seeigecannon/DC27EnterpriseBadge/Board/enterprisePhaserTest.dxf

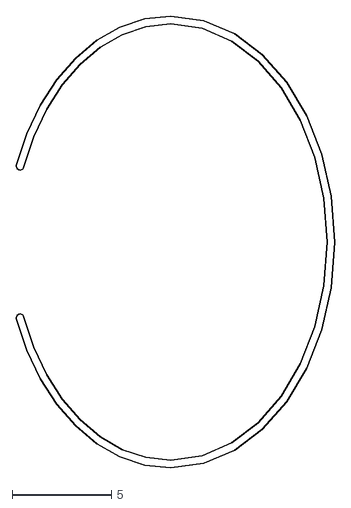
[picture p1: CAD file, 2019-08-08]
Board/enterprisePhaserTest.dxf
16.0 x 22.7
