seeigecannon/DC27EnterpriseBadge/Board/enterpriseNCCText.dxf

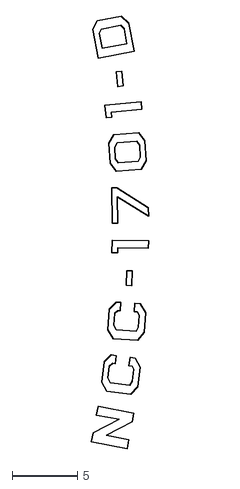
[picture p2: CAD file, 2019-08-08]
Board/enterpriseNCCText.dxf
4.38 x 33.1
