seeigecannon/DC27EnterpriseBadge/Board/enterpriseLineArt.dxf

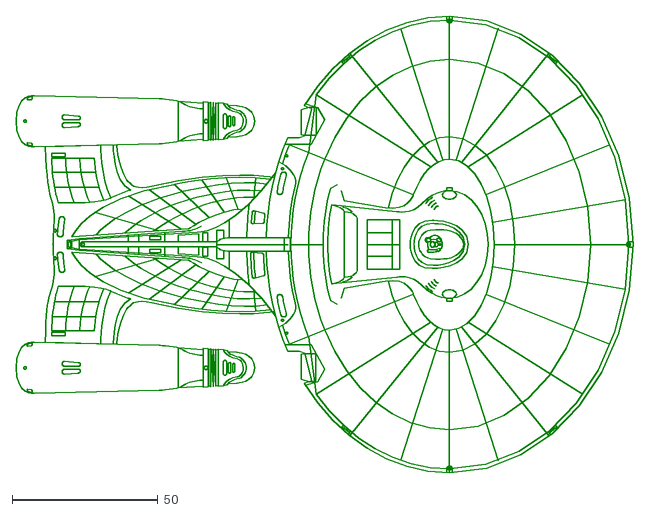
[picture p3: CAD file, 2019-08-08]
Board/enterpriseLineArt.dxf
211.4 x 156.4
