seeigecannon/DC27EnterpriseBadge/Board/enterprisePhaser.dxf

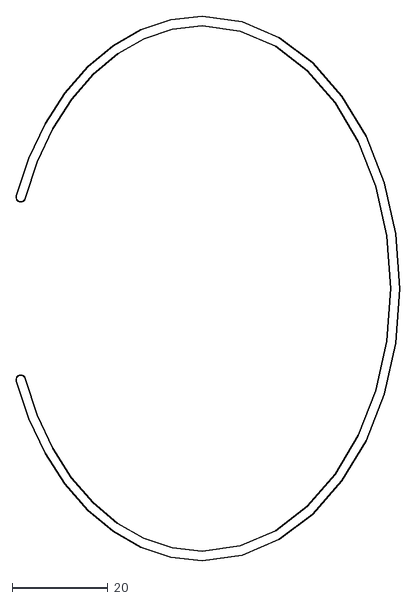
[picture p4: CAD file, 2019-08-08]
Board/enterprisePhaser.dxf
80.1 x 113.6
