seeigecannon/DC27EnterpriseBadge/Board/enterprisePhaserThin.dxf

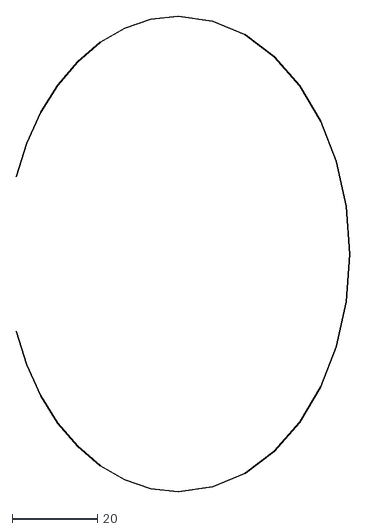
[picture p5: CAD file, 2019-08-08]
Board/enterprisePhaserThin.dxf
78.5 x 111.8
