seeigecannon/DC27EnterpriseBadge/Board/enterpriseOutline.dxf

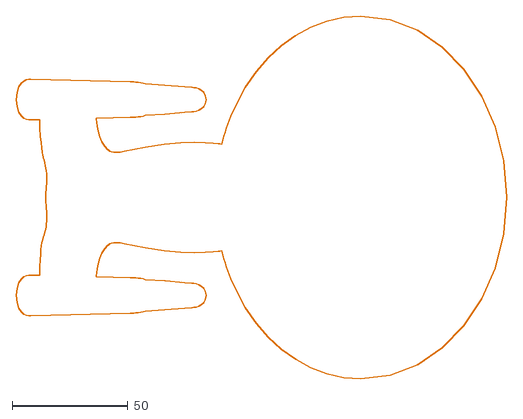
[picture p6: CAD file, 2019-08-08]
Board/enterpriseOutline.dxf
211.4 x 156.4
