seeigecannon/DC27EnterpriseBadge/Board/EnterpriseBadgeSchematic.pdf

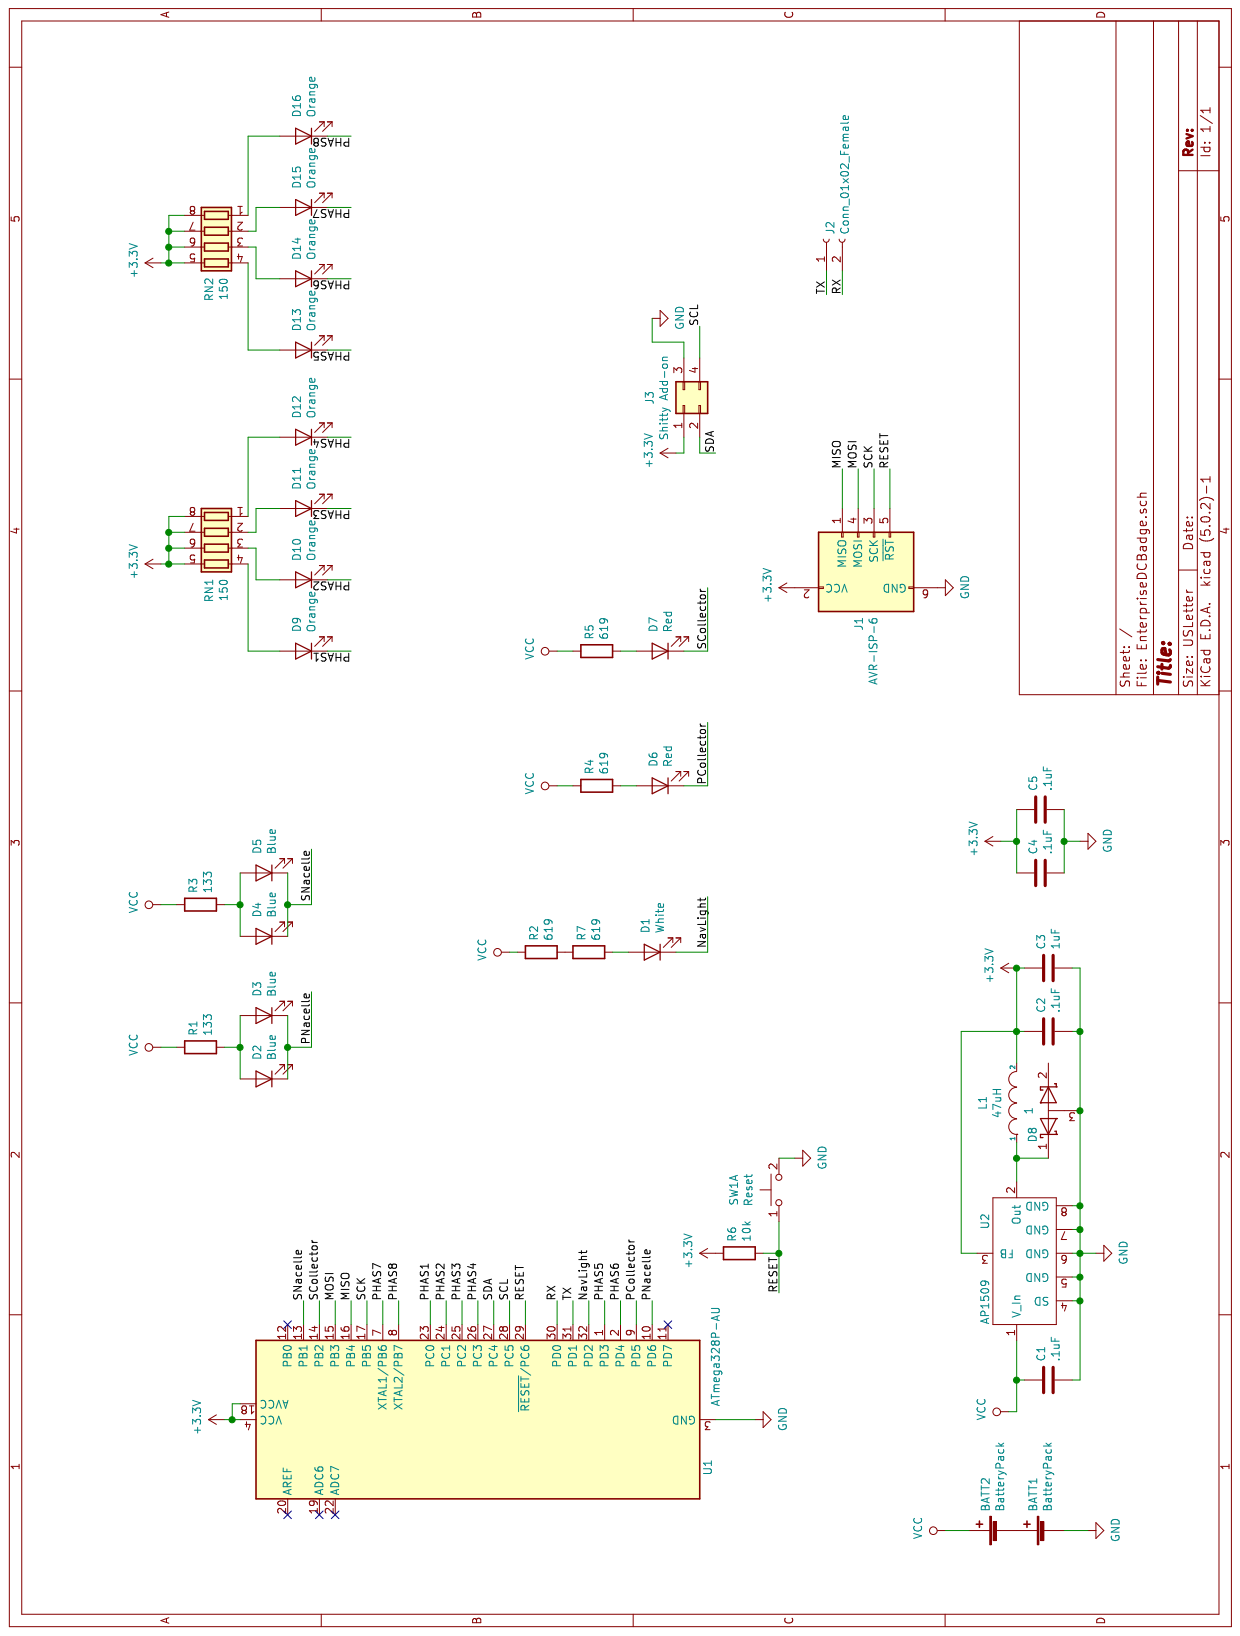
[picture p7: page 1]
