seeigecannon/DC27EnterpriseBadge/Board/EnterpriseDCBadge.kicad_pcb

## KiCad design Board/EnterpriseDCBadge.kicad_pcb (2019-08-08)

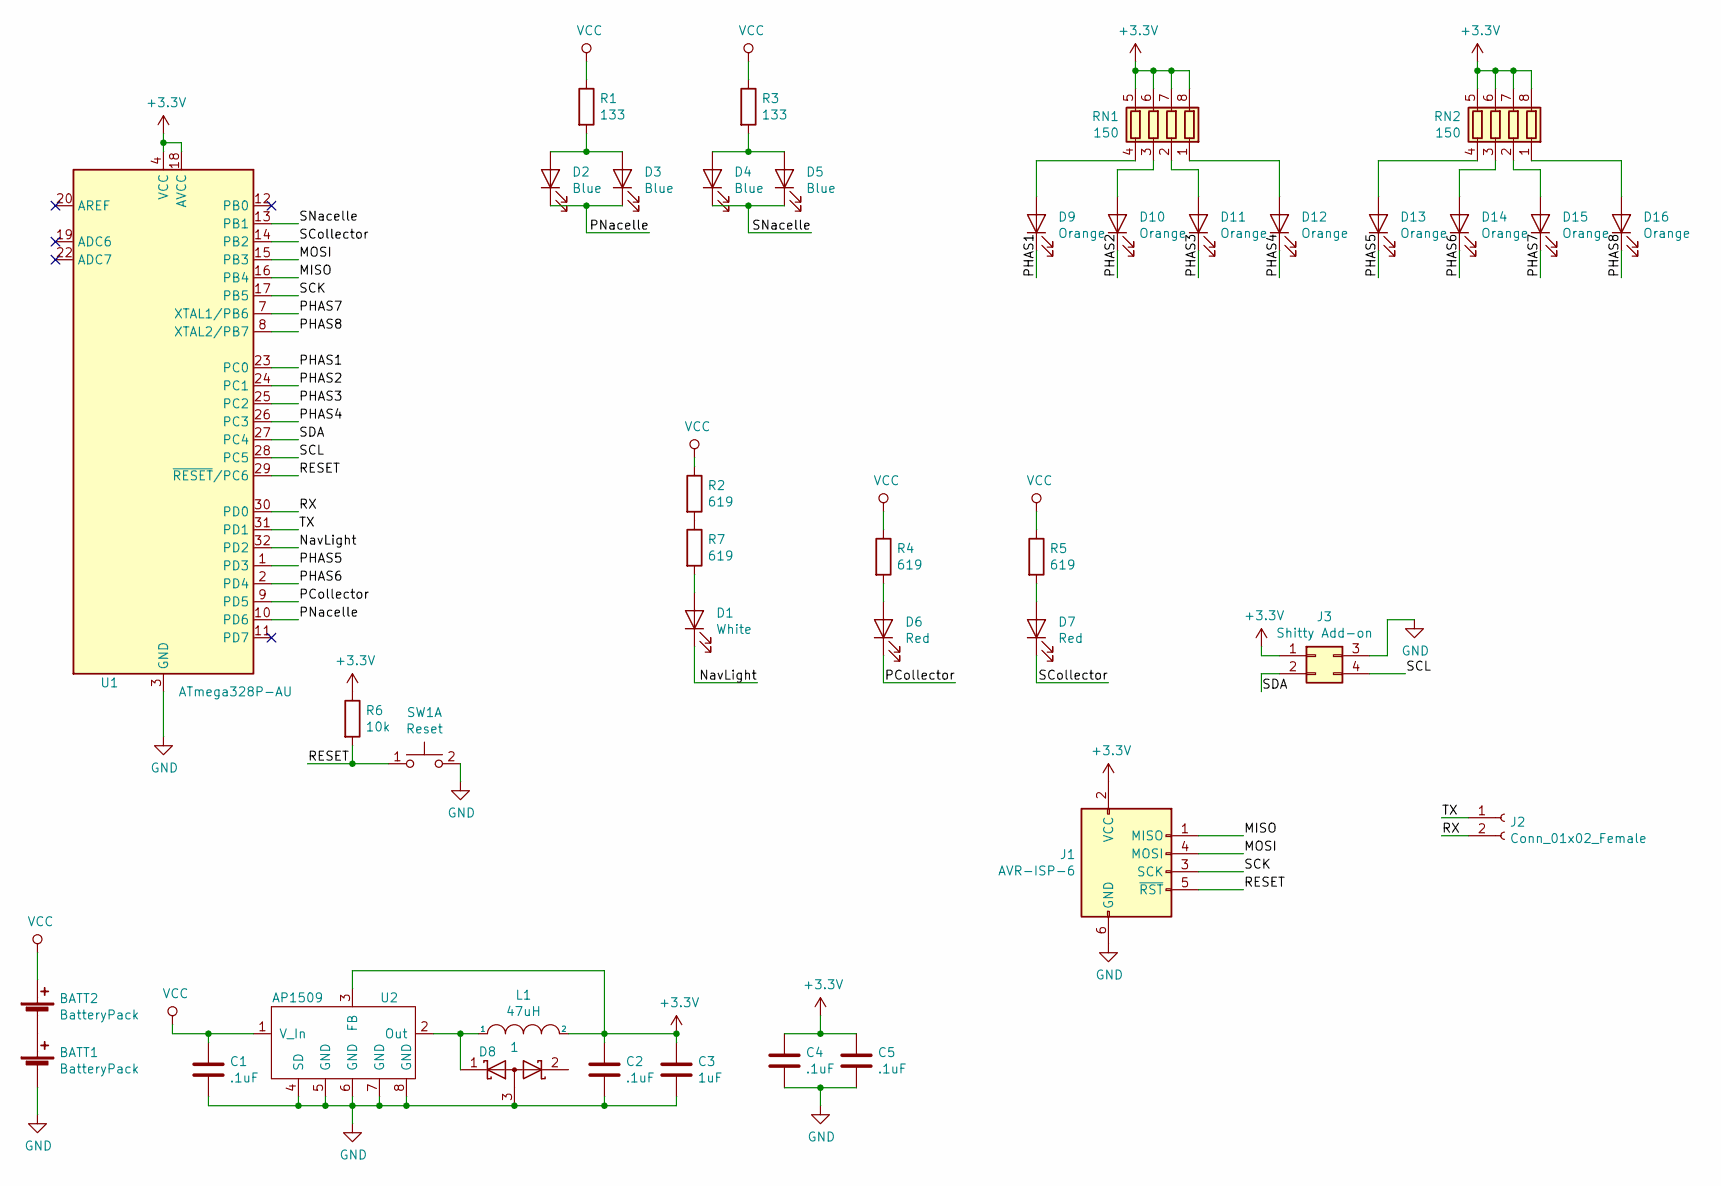
[picture p8: schematic EnterpriseDCBadge.sch]

Parts:
BATT1, BATT2: BatteryPack; BatteryHolder_MPD_BC12AAPC_2xAA_noHoles; Part Number BC12AAPC-ND
C1, C2, C4: .1uF; C_1206_3216Metric; Part Number 732-8086-1-ND
C3: 1uF; C_1206_3216Metric; Part Number 732-7685-1-ND
C5: .1uF; C_1206_3216Metric
D1: White; 3.8x1.2mm; Part Number 160-1869-1-ND
D2, D3, D4, D5: Blue; 2PLCC_flipped_noHole; Part Number 1497-1233-1-ND
D6, D7: Red; 2PLCC_flipped_noHole; Part Number 1497-1331-1-ND
D8: 1; SOT-23; Part Number BAS40-06LT1GOSCT-ND
D9, D10, D11, D12, D13, D14, D15, D16: Orange; 2PLCC_flipped_noHole; Part Number 475-2698-1-ND
J1: AVR-ISP-6; PinHeader_2x03_P2.54mm_Vertical; Part Number 609-3210-ND
J2: Conn_01x02_Female; PinHeader_1x02_P2.54mm_Vertical; Part Number 609-4434-ND
J3: Shitty Add-on; PinHeader_2x02_P2.54mm_Vertical; Part Number S7070-ND
L1: 47uH; L_1206_3216Metric_Pad1.42x1.75mm_HandSolder; Part Number 490-12803-1-ND
R1, R3: 133; R_1206_3216Metric; Part Number 311-133FRCT-ND
R2, R4, R5, R7: 619; R_1206_3216Metric; Part Number 311-619FRCT-ND
R6: 10k; R_1206_3216Metric; Part Number RMCF1206FT10K0CT-ND
RN1, RN2: 150; R_Array_Convex_4x1206; Part Number 744C083151JPCT-ND
SW1: Reset; SW_SPST_EVQQ2; Part Number CKN9088CT-ND
U1: ATmega328P-AU; TQFP-32_7x7mm_P0.8mm; Part Number ATMEGA328P-AURCT-ND
U2: AP1509; PowerIntegrations_SO-8; Part Number AP1509-33SGDICT-ND

Connections:
+3V3: C2.1, C3.1, C4.1, C5.1, J1.2 (VCC), J3.1, L1.2, R6.1, RN1.5 (R4.2), RN1.6 (R3.2), RN1.7 (R2.2), RN1.8 (R1.2), RN2.5 (R4.2), RN2.6 (R3.2), RN2.7 (R2.2), RN2.8 (R1.2), U1.4 (VCC), U1.6 (VCC), U1.18 (AVCC), U2.3 (FB)
/MISO: J1.1 (MISO), U1.16 (PB4)
/MOSI: J1.4 (MOSI), U1.15 (PB3)
/NavLight: D1.1 (K), U1.32 (PD2)
/PCollector: D6.1 (K), U1.9 (PD5)
/PHAS1: D9.1 (K), U1.23 (PC0)
/PHAS2: D10.1 (K), U1.24 (PC1)
/PHAS3: D11.1 (K), U1.25 (PC2)
/PHAS4: D12.1 (K), U1.26 (PC3)
/PHAS5: D13.1 (K), U1.1 (PD3)
/PHAS6: D14.1 (K), U1.2 (PD4)
/PHAS7: D15.1 (K), U1.7 (XTAL1/PB6)
/PHAS8: D16.1 (K), U1.8 (XTAL2/PB7)
/PNacelle: D2.1 (K), D3.1 (K), U1.10 (PD6)
/RESET: J1.5 (~RST), R6.2, SW1.1 (A), U1.29 (~RESET~/PC6)
/RX: J2.2, U1.30 (PD0)
/SCK: J1.3 (SCK), U1.17 (PB5)
/SCL: J3.4, U1.28 (PC5)
/SCollector: D7.1 (K), U1.14 (PB2)
/SDA: J3.2, U1.27 (PC4)
/SNacelle: D4.1 (K), D5.1 (K), U1.13 (PB1)
/TX: J2.1, U1.31 (PD1)
GND: BATT1.2 (-), C1.2, C2.2, C3.2, C4.2, C5.2, D8.3 (A), J1.6 (GND), J3.3, SW1.2 (B), U1.3 (GND), U1.5 (GND), U1.21 (GND), U2.4 (SD), U2.5 (GND), U2.6 (GND), U2.7 (GND), U2.8 (GND)
unnamed: BATT1.1 (+), BATT2.2 (-)
unnamed: D1.2 (A), R7.2
unnamed: D2.2 (A), D3.2 (A), R1.2
unnamed: D4.2 (A), D5.2 (A), R3.2
unnamed: D6.2 (A), R4.2
unnamed: D7.2 (A), R5.2
unnamed: D8.1 (K), L1.1, U2.2 (Out)
unnamed: D9.2 (A), RN1.4 (R4.1)
unnamed: D10.2 (A), RN1.3 (R3.1)
unnamed: D11.2 (A), RN1.2 (R2.1)
unnamed: D12.2 (A), RN1.1 (R1.1)
unnamed: D13.2 (A), RN2.4 (R4.1)
unnamed: D14.2 (A), RN2.3 (R3.1)
unnamed: D15.2 (A), RN2.2 (R2.1)
unnamed: D16.2 (A), RN2.1 (R1.1)
unnamed: R2.2, R7.1
VCC: BATT2.1 (+), C1.1, R1.1, R2.1, R3.1, R4.1, R5.1, U2.1 (V_In)

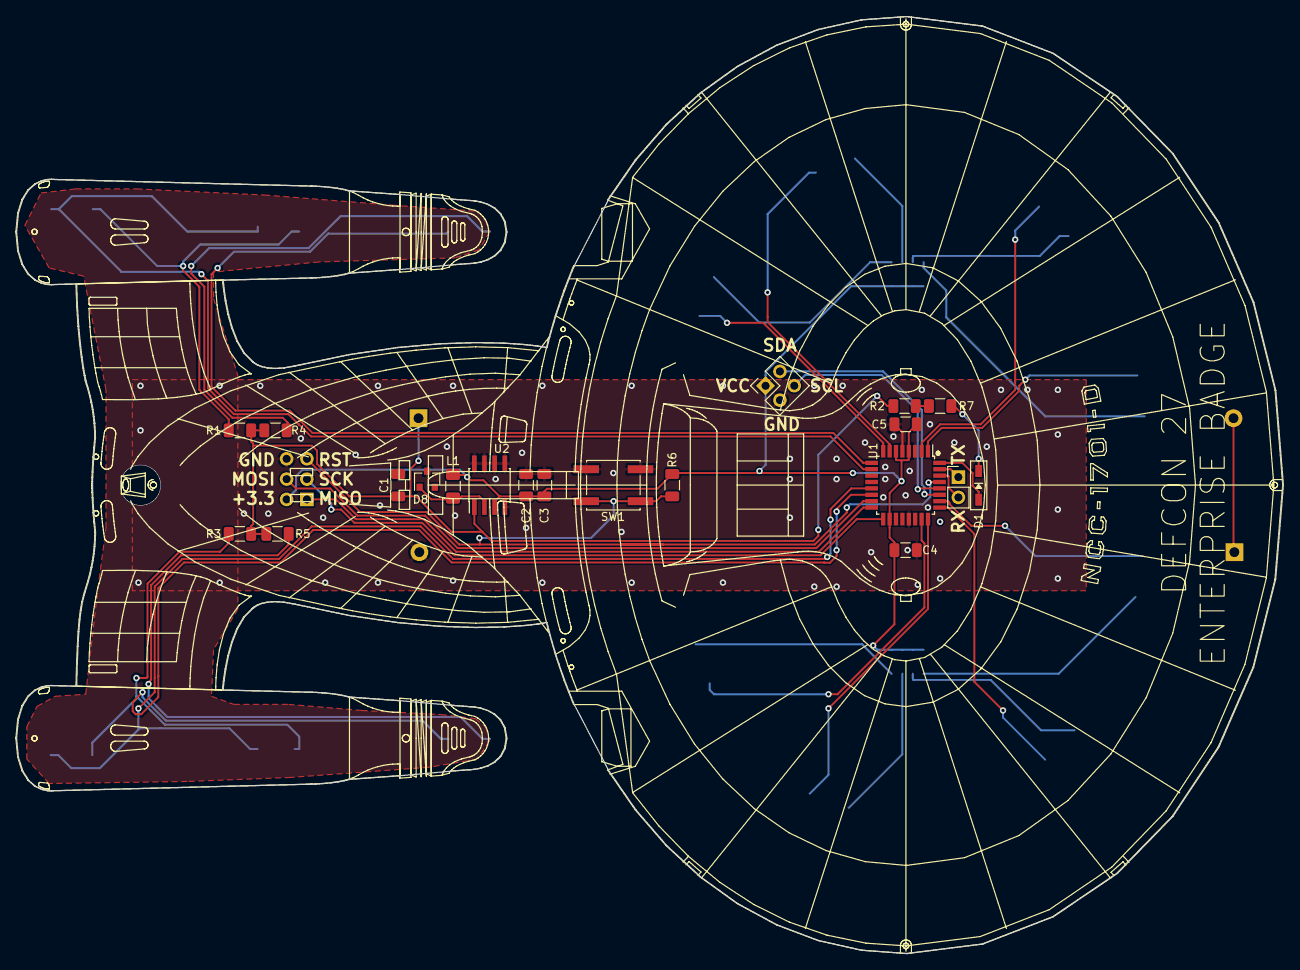
[picture p9: board EnterpriseDCBadge.kicad_pcb from above]

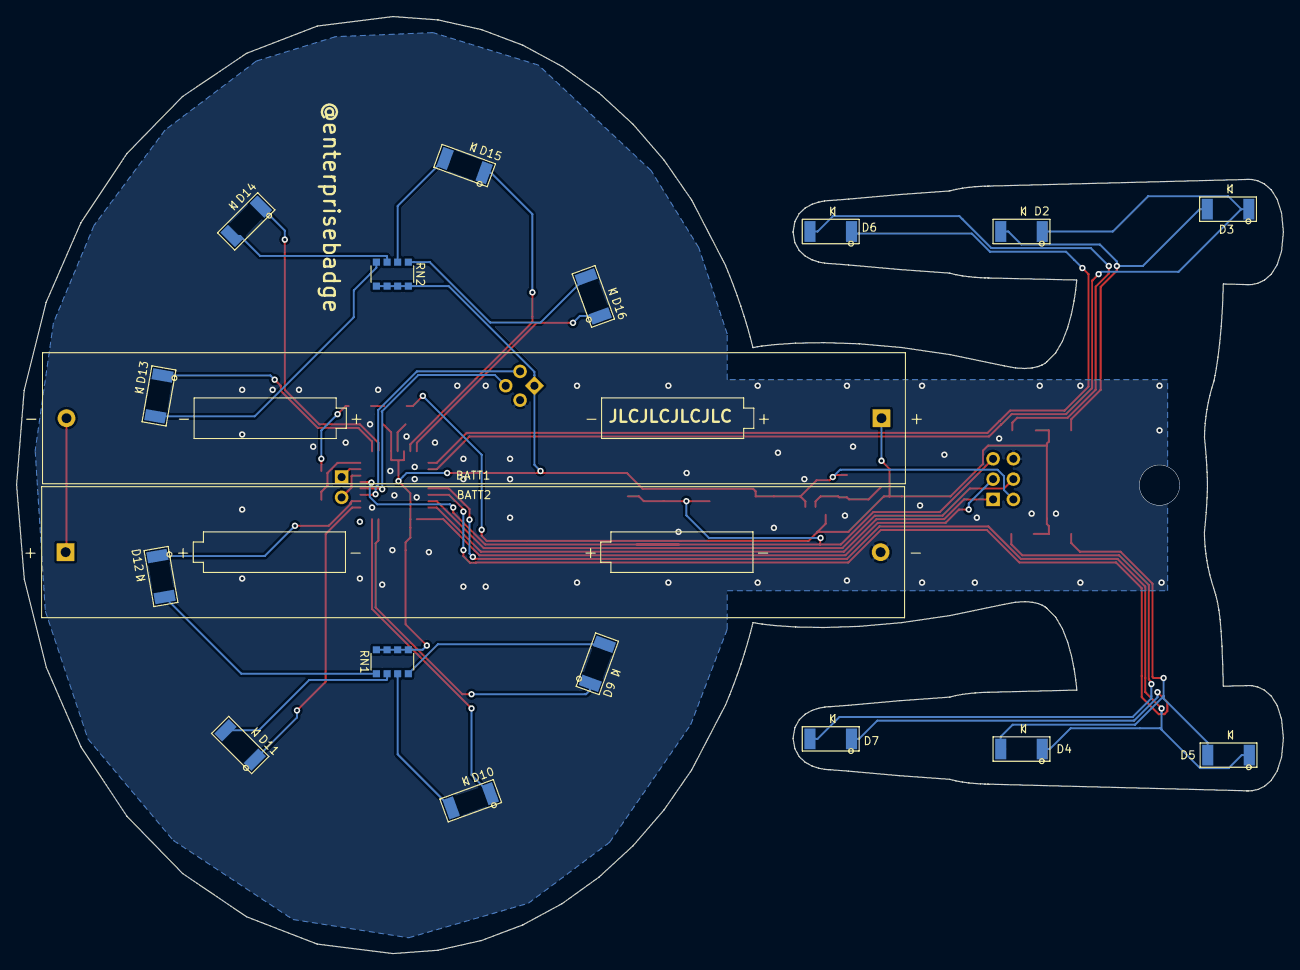
[picture p10: board EnterpriseDCBadge.kicad_pcb from below]

Board: 2 copper layers, 158.6 x 117.3 mm, 39 parts (18 on the bottom side), 40 nets.
