seeigecannon/DC27EnterpriseBadge/code/enterpriseCode/enterpriseCode.ino

#include <avr/power.h>
#include <avr/sleep.h>
#include <avr/wdt.h>
#include <EEPROM.h>

void setOtherLEDs();
void setPhasers(uint8_t phaserArray);
void POST();
void NavLightToggle(bool navLightOn);
void damageNacelles(int damage);
void firePhasers();

long unsigned int timer=0;
long unsigned int lastTimer=0;
unsigned int timerDelay=10;   //milliseconds per run
long unsigned int randomPhaserTimer=random(5000);
long unsigned int randomPhaserTimerBuffer=0;
unsigned int boardMode;     //modes: normal phaser, binary counter, larson scanner, disco

uint8_t otherLEDs=B0000000;    //0,0,0,PNacelle,PCollector/NavLight/SCollector,SNacelle
const uint8_t PNacelle     = 0b00010000;
const uint8_t PCollector   = 0b00001000;
const uint8_t NavLight     = 0b00000100;
const uint8_t SCollector   = 0b00000010;
const uint8_t SNacelle     = 0b00000001;
unsigned short phaserCounter=0;
byte larsonScanner=B00000001;
bool larsonScannerDirection=false;
/**
 * PFM profiles were generated with the following python code:
 *
 * import math
 *
 * sigmoid = lambda x: math.exp(x) / (1.0 + math.exp(x))
 *
 * pulse_profile1 = [ 10000.0*sigmoid(10.0 * (x / 100.0) - 5.0) for x in range(0, 100, 1) ]
 * pulse_profile2 = [ 7000.0*sigmoid(10.0 * (x / 100.0) - 5.0) for x in range(0, 100, 1) ]
 * pulse_profile3 = [ 5000.0*sigmoid(10.0 * (x / 100.0) - 5.0) for x in range(0, 100, 1) ]
 * pulse_profile4 = [ 3500.0*sigmoid(10.0 * (x / 100.0) - 5.0) for x in range(0, 100, 1) ]
 *
 * A few notes about the above:
 *
 * 1.  PFM profiles represent a sequence of pulse periods in microseconds.  LEDs are dimmed
 *     using PFM at 50% DC and the given pulse periods.
 * 2.  sum(pulse_profile1) ~= 500e3, i.e. 500ms
 *     sum(pulse_profile2) ~= 70%*sum(pulse_profile1)
 *     sum(pulse_profile3) ~= 70%*sum(pulse_profile2)
 *     sum(pulse_profile4) ~= 70%*sum(pulse_profile3)
 *
 */
const uint16_t pulse_profile1[] = {
	66.928509242848563,
    73.915413442819712,
    81.625711531598967,
    90.132986528478227,
    99.518018669043258,
    109.8694263059318,
    121.28434984274234,
    133.86917827664777,
    147.74031693273057,
    163.02499371440948,
    179.86209962091556,
    198.40305734077509,
    218.81270936130477,
    241.270214176692,
    265.96993576865862,
    293.12230751356316,
    322.95464698450508,
    355.71189272636178,
    391.65722796764356,
    431.07254941086114,
    474.25873177566785,
    521.53563078417733,
    573.24175898868759,
    629.73356056996511,
    691.3842034334682,
    758.58180021243561,
    831.72696493922376,
    911.22961014856151,
    997.50489119685176,
    1090.9682119561294,
    1192.0292202211754,
    1301.0847436299785,
    1418.5106490048781,
    1544.6526508353472,
    1679.8161486607555,
    1824.2552380635632,
    1978.1611144141821,
    2141.6501695744146,
    2314.7521650098233,
    2497.3989440488244,
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
};
const uint16_t pulse_profile2[] = {
	46.849956469993991,
    51.740789409973793,
    57.137998072119274,
    63.093090569934752,
    69.662613068330288,
    76.908598414152252,
    84.899044889919637,
    93.70842479365345,
    103.41822185291139,
    114.11749560008664,
    125.90346973464089,
    138.88214013854258,
    153.16889655291334,
    168.88914992368439,
    186.17895503806102,
    205.1856152594942,
    226.06825288915357,
    248.99832490845327,
    274.16005957735047,
    301.75078458760282,
    331.98111224296753,
    365.07494154892419,
    401.26923129208132,
    440.8134923989756,
    483.96894240342772,
    531.007260148705,
    582.20887545745666,
    637.860727103993,
    698.25342383779628,
    763.67774836929061,
    834.42045415482278,
    910.759320540985,
    992.95745430341481,
    1081.2568555847431,
    1175.8713040625289,
    1276.9786666444943,
    1384.7127800899273,
    1499.15511870209,
    1620.3265155068762,
    1748.1792608341771,
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
};
const uint16_t pulse_profile3[] = {
	33.464254621424281,
    36.957706721409856,
    40.812855765799483,
    45.066493264239114,
    49.759009334521629,
    54.9347131529659,
    60.642174921371172,
    66.934589138323886,
    73.870158466365282,
    81.512496857204738,
    89.931049810457779,
    99.201528670387546,
    109.40635468065239,
    120.635107088346,
    132.98496788432931,
    146.56115375678158,
    161.47732349225254,
    177.85594636318089,
    195.82861398382178,
    215.53627470543057,
    237.12936588783393,
    260.76781539208866,
    286.6208794943438,
    314.86678028498255,
    345.6921017167341,
    379.2909001062178,
    415.86348246961188,
    455.61480507428075,
    498.75244559842588,
    545.48410597806469,
    596.01461011058768,
    650.54237181498922,
    709.25532450243907,
    772.32632541767362,
    839.90807433037776,
    912.12761903178159,
    989.080557207091,
    1070.8250847872073,
    1157.3760825049117,
    1248.6994720244122,
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
};
const uint16_t pulse_profile4[] = {
	23.424978234996995,
    25.870394704986897,
    28.568999036059637,
    31.546545284967376,
    34.831306534165144,
    38.454299207076126,
    42.449522444959818,
    46.854212396826725,
    51.709110926455693,
    57.058747800043321,
    62.951734867320447,
    69.441070069271291,
    76.584448276456669,
    84.444574961842193,
    93.08947751903051,
    102.5928076297471,
    113.03412644457679,
    124.49916245422664,
    137.08002978867523,
    150.87539229380141,
    165.99055612148376,
    182.53747077446209,
    200.63461564604066,
    220.4067461994878,
    241.98447120171386,
    265.50363007435249,
    291.10443772872833,
    318.93036355199649,
    349.12671191889814,
    381.83887418464531,
    417.21022707741139,
    455.37966027049248,
    496.4787271517074,
    540.62842779237155,
    587.93565203126445,
    638.48933332224715,
    692.35639004496363,
    749.577559351045,
    810.16325775343807,
    874.08963041708853,
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
};
void readSetEEPROM(){
    if(EEPROM.read(0)>3){   //if EEPROM is too high, reset back to 0
        EEPROM.write(0,0);
    }
    boardMode=EEPROM.read(0);
    EEPROM.write(0,boardMode+1);
    //setPhasers(EEPROM.read(0)+1); //debug
}
// the setup function runs once when you press reset or power the board
void setup() {
    wdt_enable(WDTO_8S);
    delay(50);  //debounce reset button
    readSetEEPROM();    //change mode with reset button
    ADCSRA = 0; //disable ADC to save power
    POST();
    
}

// otherLEDs:
//   bit 4: PNacelle
//   bit 3: PCollector
//   bit 2: NavLight
//   bit 1: SCollector
//   bit 0: SNacelle
void setOtherLEDs() {
    // PNacelle = PD6
    // PCollector = PD5
    // NavLight = PD2
    // SCollector = PB2
    // SNacelle = PB1
	static const uint8_t DDRDMask = 0b01100100;
	static const uint8_t DDRBMask = 0b00000110;
    bool pNacelle = otherLEDs & PNacelle;
    bool pCollector = otherLEDs & PCollector;
    bool navLight = otherLEDs & NavLight;
    bool sCollector = otherLEDs & SCollector;
    bool sNacelle = otherLEDs & SNacelle;
    DDRD = DDRD & ~DDRDMask | (pNacelle << 6) | (pCollector << 5) | (navLight << 2);
    DDRB = DDRB & ~DDRBMask | (sCollector << 2) | (sNacelle << 1);
}

void setPhasers(uint8_t phaserMask) {
    //PHAS1=PC0
    //PHAS2=PC1
    //PHAS3=PC2
    //PHAS4=PC3
    //PHAS5=PD3
    //PHAS6=PD4
    //PHAS7=PB6
    //PHAS8=PB7
	static const uint8_t DDRBMask = 0b11000000;
	static const uint8_t DDRCMask = 0b00001111;
	static const uint8_t DDRDMask = 0b00110000;
    uint8_t DDRBbits = phaserMask & DDRBMask;
    uint8_t DDRCbits = phaserMask & DDRCMask;
    uint8_t DDRDbits = phaserMask & DDRDMask;
    DDRB = DDRB & ~DDRBMask | DDRBbits;
    DDRC = DDRC & ~DDRCMask | DDRCbits;
    DDRD = DDRD & ~(DDRDMask >> 1) | (DDRDbits >> 1);
}
void POST(){
    uint8_t phaserTest=B0000001;
    otherLEDs=B00000001;
    for(int i=0; i<9; i++){
        setPhasers(phaserTest);
        delay(200);
        phaserTest=phaserTest<<1;
    }
    for(int i=0; i<6; i++){
        setOtherLEDs();
        delay(200);
        otherLEDs=otherLEDs<<1;
    }
}
void NavLightToggle(bool navLightOn=false){
    //otherLEDs=otherLEDs^B00000100;
    if(navLightOn){
        otherLEDs |= NavLight;
    }
    else{
        otherLEDs &= ~NavLight;
    }
    setOtherLEDs();
}
void damageNacelles(int damage=0){
    if(damage==0){
        otherLEDs &= NavLight;
    }
    else if(damage==1){
        otherLEDs &= NavLight|SCollector|SNacelle;
    }
    else if (damage==2){
        otherLEDs &= NavLight|PCollector|PNacelle;
    }
    else{
        otherLEDs |= PCollector|PNacelle|SCollector|SNacelle;
    }
    setOtherLEDs();
}

void loop() {
    wdt_reset();
    if(boardMode==0){   //normalMode
        if(millis()-lastTimer>timerDelay){
            lastTimer=millis();
        }
        if(millis()-randomPhaserTimerBuffer>randomPhaserTimer){
            randomPhaserTimerBuffer=millis();
            randomPhaserTimer=random(10000);
            damageNacelles(random(0,20));
            
            firePhasers();
        }
        //otherLEDs = PCollector|PNacelle|SCollector|SNacelle;
        NavLightToggle(1);
    }
    else if(boardMode==1){  //binCounter mode

        setPhasers(phaserCounter);
        otherLEDs=phaserCounter>>8;
        setOtherLEDs();
        delay(100);
        phaserCounter=phaserCounter+1;
    }
    else if(boardMode==2){  //larsonScanner
        otherLEDs=B11111111;
        setOtherLEDs();
        setPhasers(larsonScanner);
        if(larsonScannerDirection==false){
            larsonScanner=larsonScanner<<1;
        }
        else{
            larsonScanner=larsonScanner>>1;
        }
        if(larsonScanner==B10000000 or larsonScanner==B00000001){
            larsonScannerDirection=!larsonScannerDirection;
        }
        delay(200);
    }
    else{       //discoMode
        setPhasers(random(255));
        otherLEDs=random();
        setOtherLEDs();
        delay(random(300,1000));
    }
}

void crossFade(uint8_t start, uint8_t end, const uint16_t pulse_periods_us[], int n_steps) {
	// PFM @start from 100% down to 0% and @end from 0% up to 100%
	for (int i = 0; i < n_steps; i++) {
		setPhasers(start);
		delayMicroseconds(pulse_periods_us[n_steps-i] / 2);
		setPhasers(end);
		delayMicroseconds(pulse_periods_us[i] / 2);
	}
	setPhasers(end);
}

void firePhasers(){
	crossFade(0b00000000, 0b10000001, pulse_profile1, sizeof(pulse_profile1)/sizeof(pulse_profile1[0]));
	crossFade(0b10000001, 0b01000010, pulse_profile2, sizeof(pulse_profile2)/sizeof(pulse_profile2[0]));
	crossFade(0b01000010, 0b00100100, pulse_profile3, sizeof(pulse_profile3)/sizeof(pulse_profile3[0]));
	crossFade(0b00100100, 0b00011000, pulse_profile4, sizeof(pulse_profile4)/sizeof(pulse_profile4[0]));
    if(random(2)==0){
        setPhasers(B00001000);
    }
    else{
        setPhasers(B00010000);
    }
    delay(600);
    setPhasers(0b00000000);
}
