seeigecannon/DC27EnterpriseBadge/(commit log)

2019-08-08 Add files via upload
    Sorry about the mess...
    [DEV_EnterpriseDCBadge.kicad_pcb, EnterpriseDCBadge - Copy.kicad_pcb, EnterpriseDCBadge.csv, EnterpriseDCBadge.kicad_pcb, EnterpriseDCBadge.sch, enterpriseLineArt.dxf, enterpriseNCCText.dxf, enterpriseOutline.dxf]
2021-08-10 Add files via upload
    Updated BOM to actually include part numbers.
    [EnterpriseDCBadge.csv]
